truongvanvuembedded/Dishwasher-machine/Bản vẽ/ELECTRONIC-DRAWING.pdf

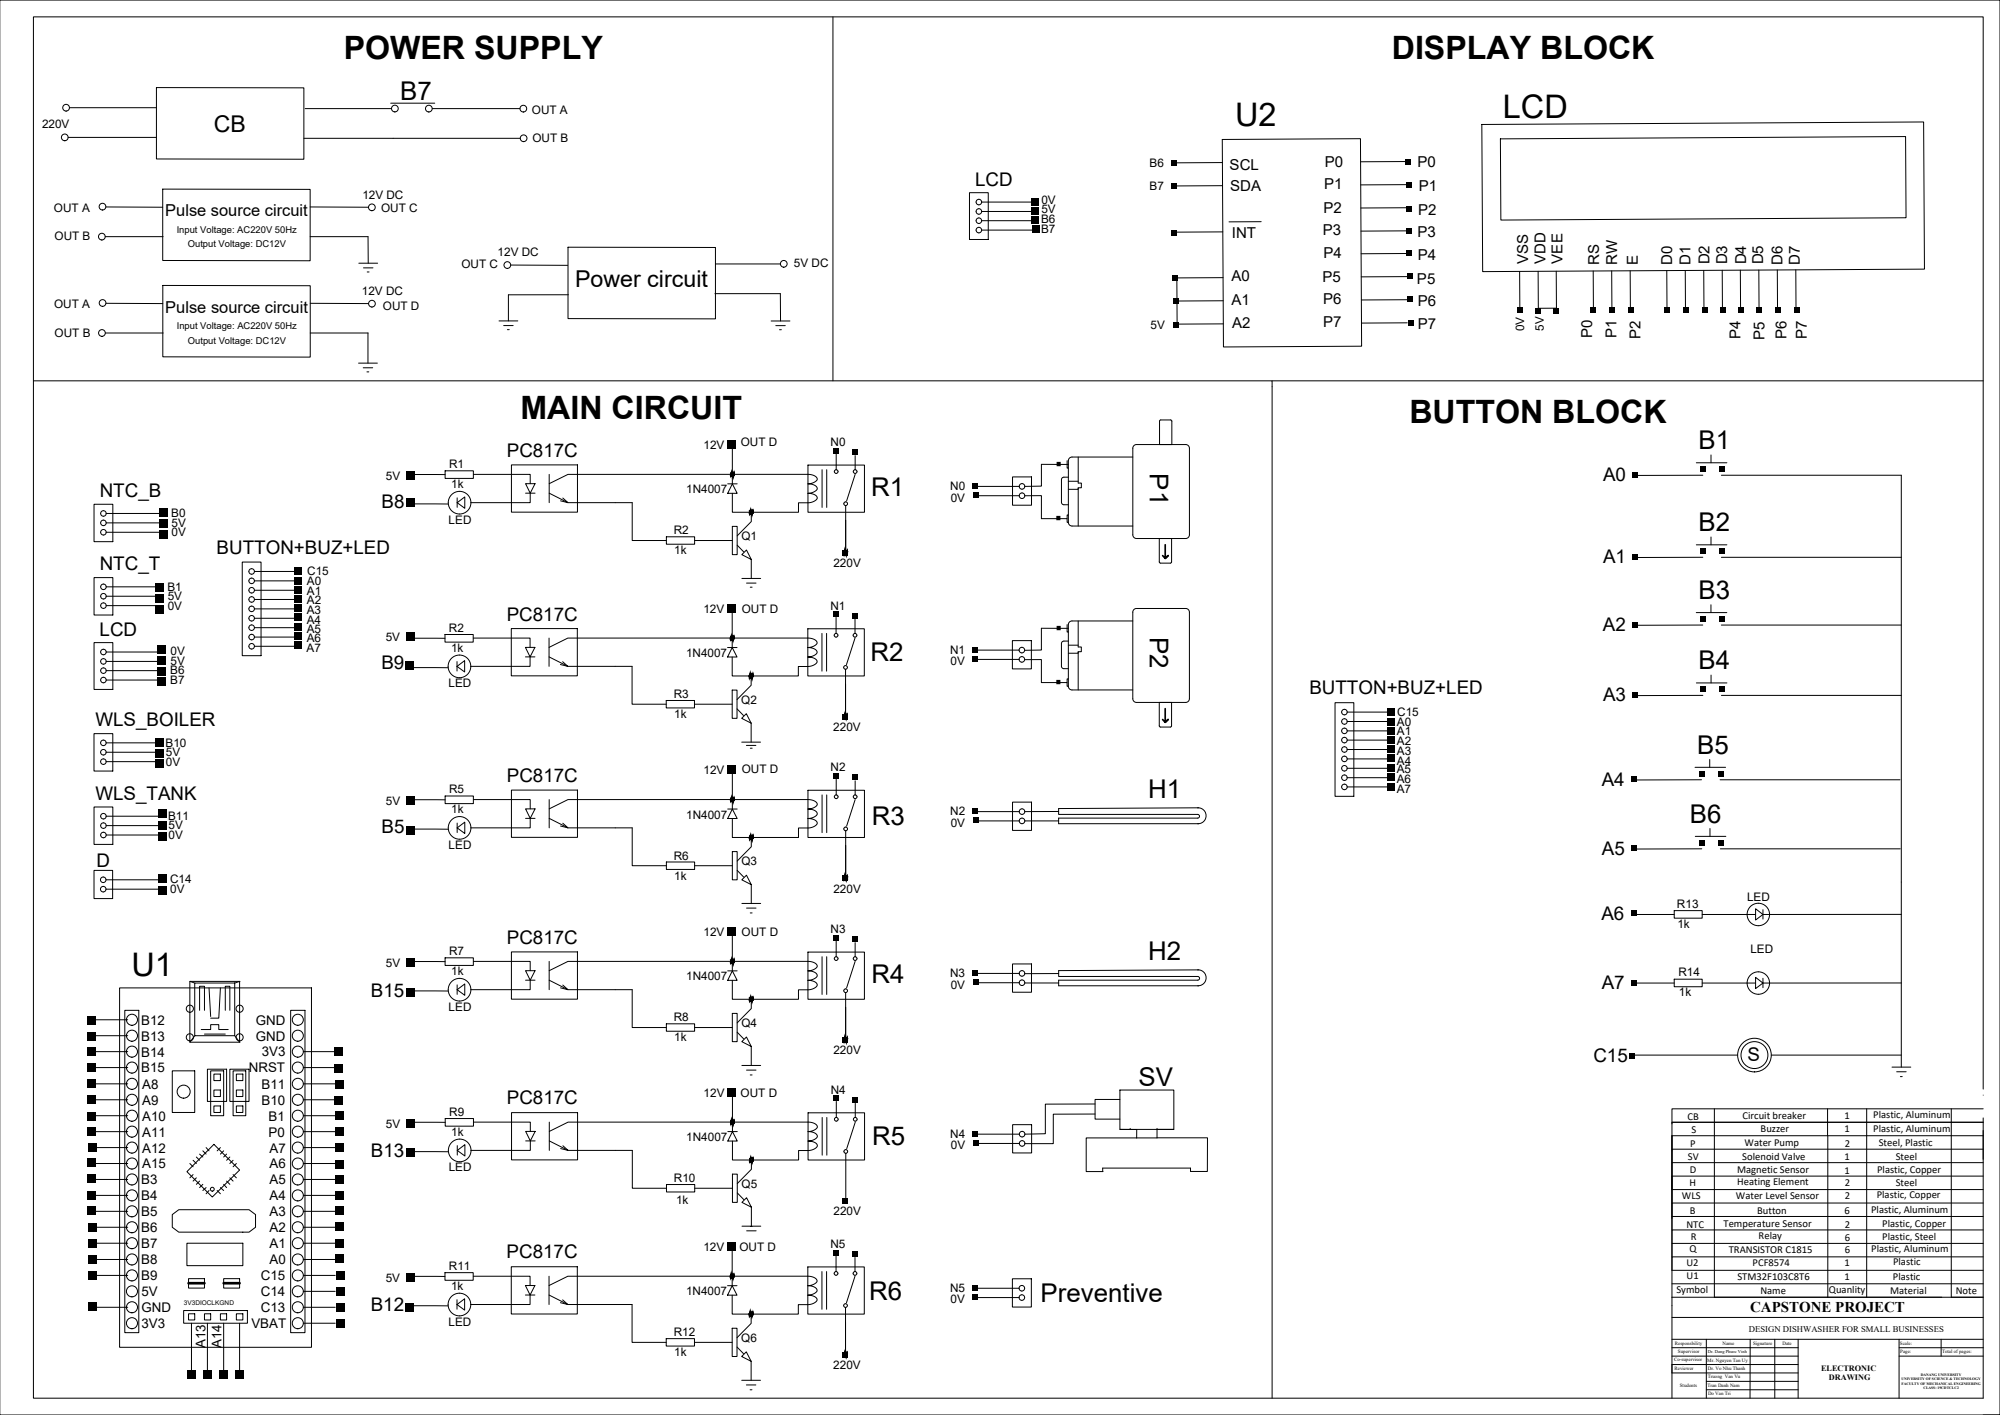
[picture p63: page 1]

5V B6B75V . .................. ................. .................. ......... .... ......... MAIN CIRCUIT DISPLAY BLOCK DESIGN DISHWASHER FOR SMALL BUSINESSES Co-supervisor Mr. Nguyen Tan Uy Tran Danh Nam Do Van Tri Truong Van Vu Plastic Q Plastic, Aluminum R Relay Plastic, Steel B Button 6 Plastic, Aluminum Plastic, Copper Preventive .... .C15 S S Buzzer 1 Plastic, Aluminum OUT A OUT B Pulse source circuit Input Voltage: AC220V 50Hz Output Voltage: DC12V 12V DC OUT A OUT B 12V DC B7 CB Circuit breaker 1 Plastic, Aluminum OUT C OUT C Reviewer Dr. Vo Nhu Thanh BUTTON BLOCK OUT D OUT D OUT D OUT D OUT D OUT D OUT D

P2 H1 H2 SV C15 A0A1A2A3A4A5A6A7 BUTTON+BUZ+LED ..B1 .A0 ..B2 .A1 ..B3 .A2 ..B4 .A3 ..B5 .A4 ..B6 .A5 .A6 .A7 R13 1kR14 1k LED LED 0V5VB6B7 LCD LCD

A14 U10V5VB6B7 LCD B05V0V NTC_B B15V0V NTC_T B10 5V0V WLS_BOILER B11 5V0V WLS_TANKC14 0V D PC817C B8 . 5V R11k LED 1N4007 12V . R21k Q1 N0 220V N0... .. 0V . PC817C B9 . 5V R21k LED 1N4007 12V . R31k Q2 N1 220V N1... .. 0V . PC817C B5 . 5V R51k LED 1N4007 12V . R61k Q3 N2 220V N2... .. 0V . PC817C B15 . 5V R71k LED 1N4007 12V . R81k Q4 N3 220V N3... .. 0V . PC817C B13 . 5V R91k LED 1N4007 12V . R10 1k Q5 N4 220V N4... .. 0V . PC817C B12 . 5V R11 1k LED 1N4007 12V . R12 1k Q6 N5 220V N5... .. 0V . R1 R2 R6R5 R4 R3 C15 A0A1A2A3A4A5A6A7 BUTTON+BUZ+LED . .
