truongvanvuembedded/Dishwasher-machine/Bản vẽ/OPERATION-PRINCIPLE.pdf

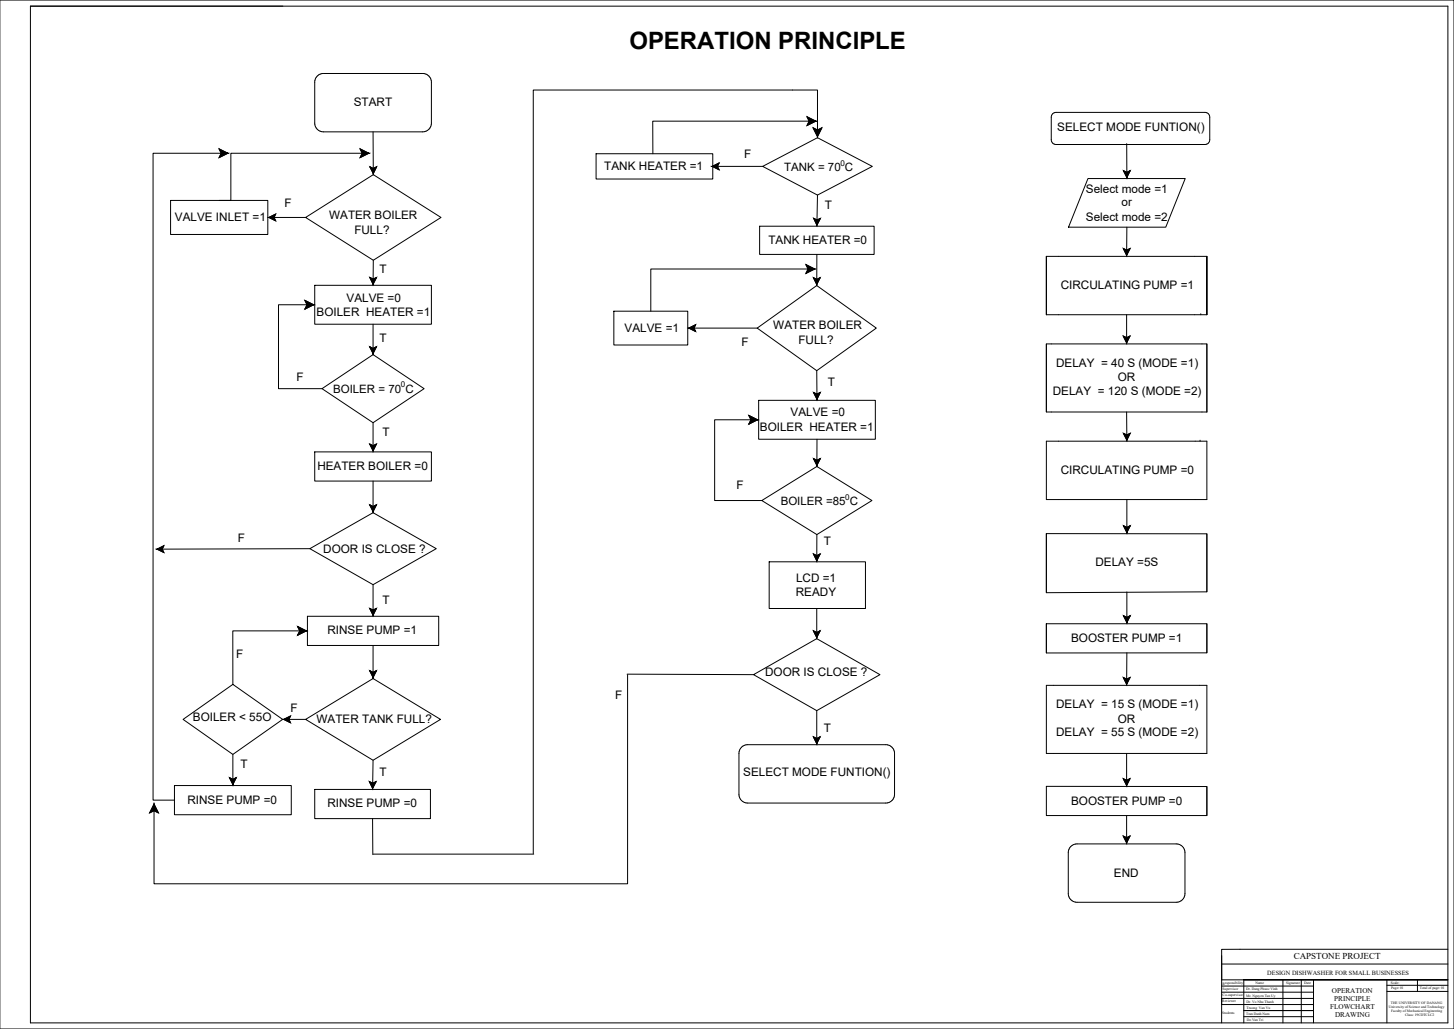
[picture p64: page 1]
WATER BOILER FULL? VALVE =0 BOILER HEATER =1 VALVE INLET =1; T HEATER BOILER =0 WATER TANK FULL? RINSE PUMP =0; TANK HEATER =1; VALVE =0 BOILER HEATER =1 LCD =1 READY DOOR IS CLOSE ? T RINSE PUMP =1 F; TANK HEATER =0 VALVE =1; WATER BOILER F; FULL?T T F BOILER < 55O; T RINSE PUMP =0 T; T DOOR IS CLOSE ? F; T START; SELECT MODE FUNTION()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
