truongvanvuembedded/Dishwasher-machine/Bản vẽ/AS-BUILT DRAWING.pdf

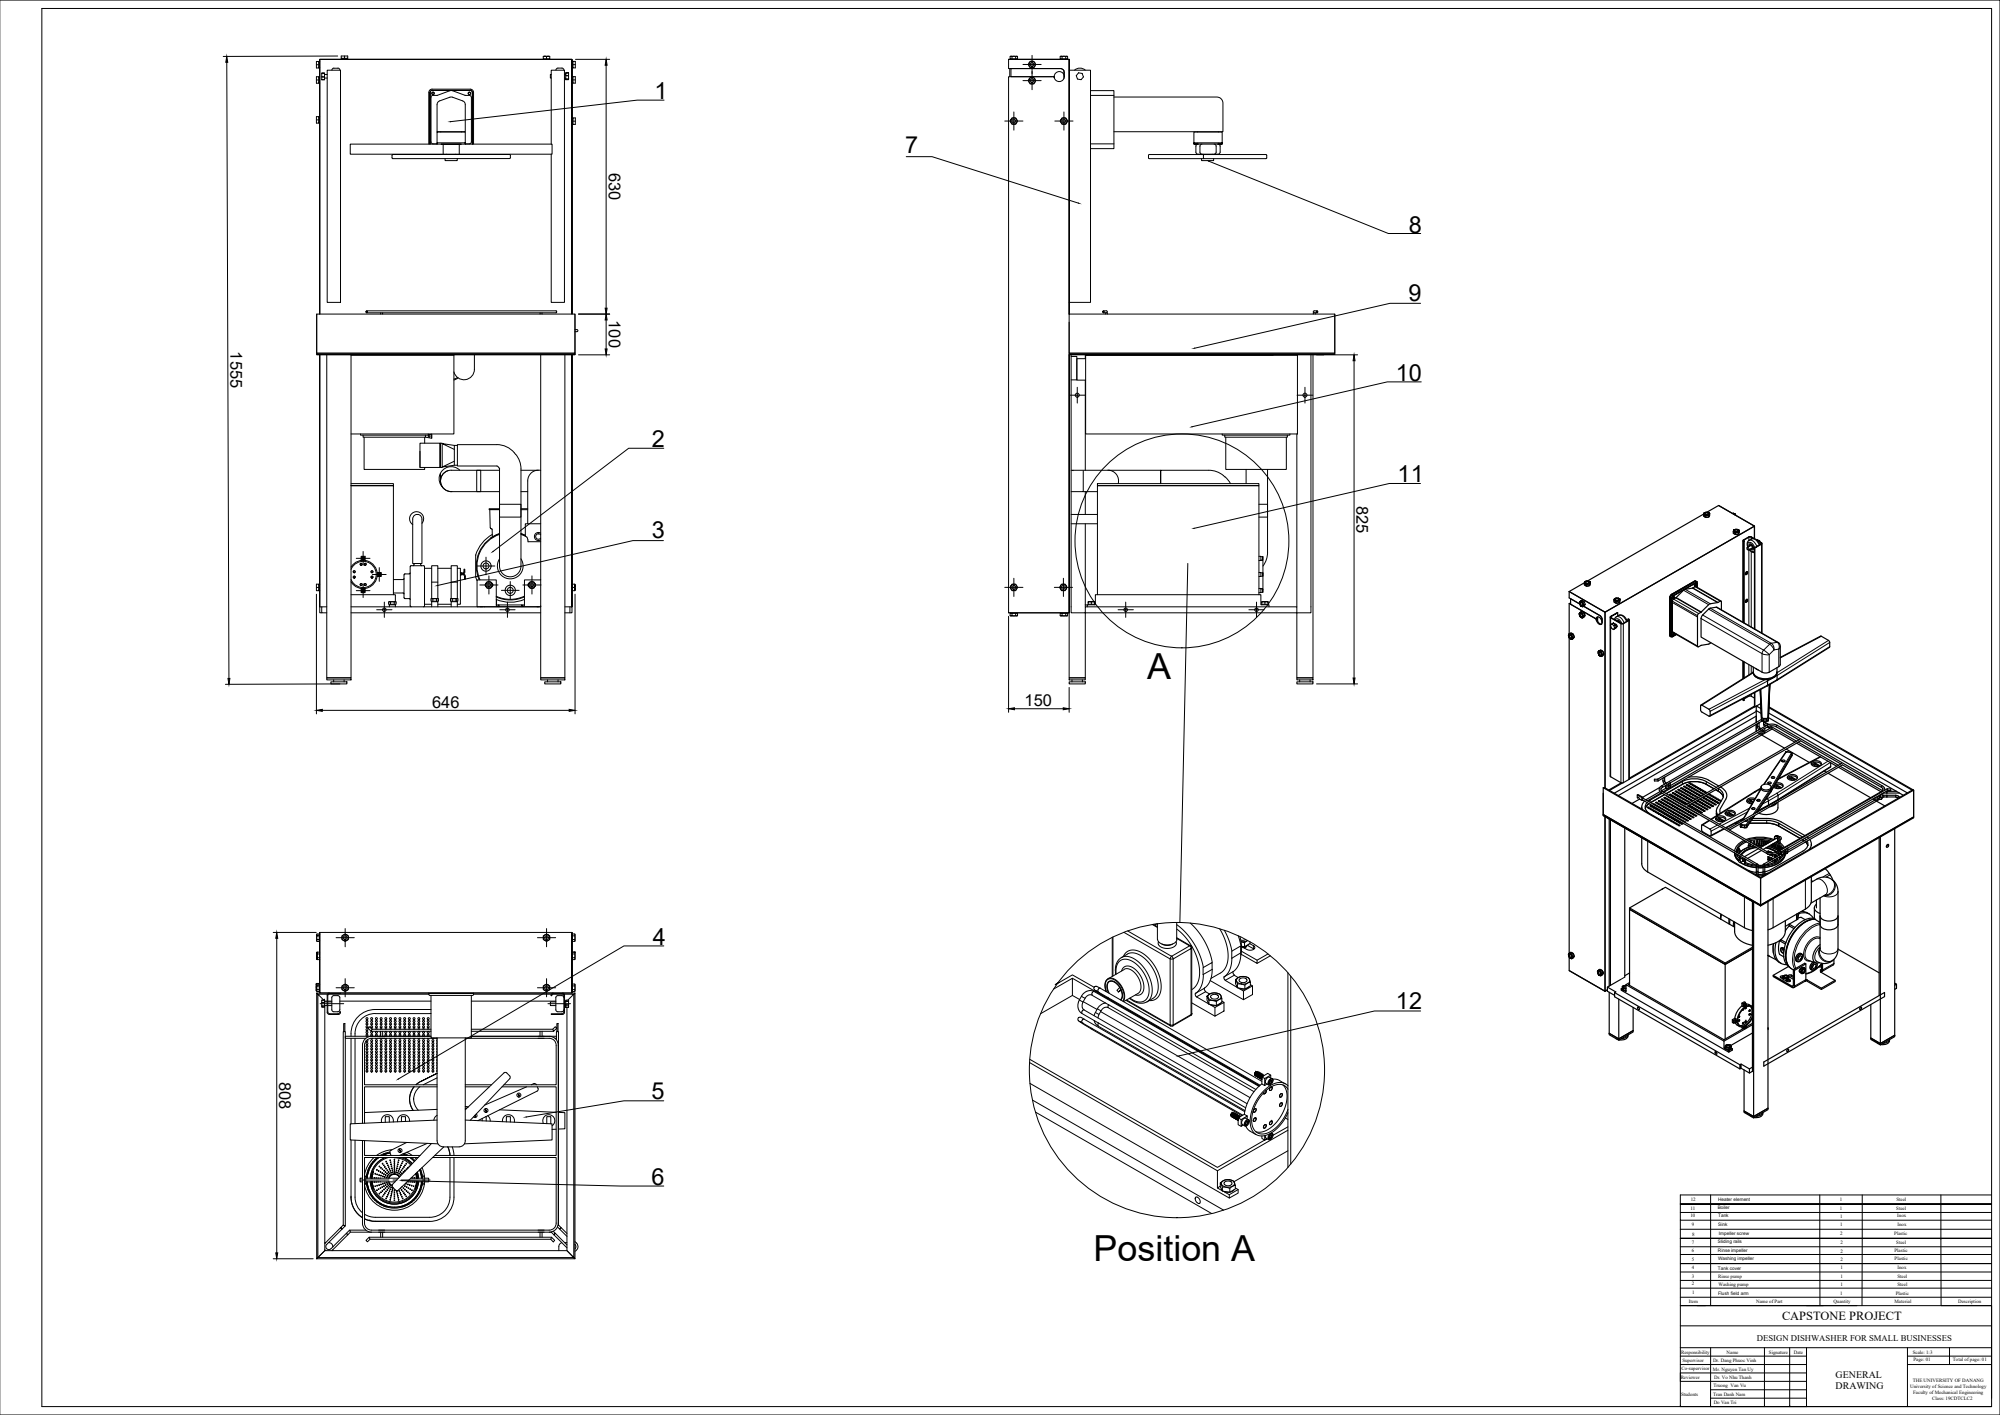
[picture p65: page 1]
CAPSTONE PROJECT DESIGN DISHWASHER FOR SMALL BUSINESSES Responsibility Supervisor Students; Name Tran Danh Nam; Signature; Date; Scale: 1:3 Page: 01; Total of page: 01 GENERAL DRAWING; THE UNIVERSITY OF DANANG University of Science and Technology Faculty of Mechanical Engineering Class: 19CDTCLC2 Dr. Dang Phuoc Vinh Do Van Tri Item; Name of Part; Quantity; Material; Description 1234 Co-supervisor 567; Inox 212112 Mr. Nguyen Tan Uy Washing pump; 2 Truong Van Vu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

1555 646 321654 11109812 Flush field arm 1 Plastic Steel 8 Impeller screw 91011 1111 Sink Inox Boiler Tank Steel Inox 12 Heater element Steel 150

100 630 Reviewer Dr. Vo Nhu Thanh
