truongvanvuembedded/Dishwasher-machine/Bản vẽ/DETAIL-DRAWING.pdf

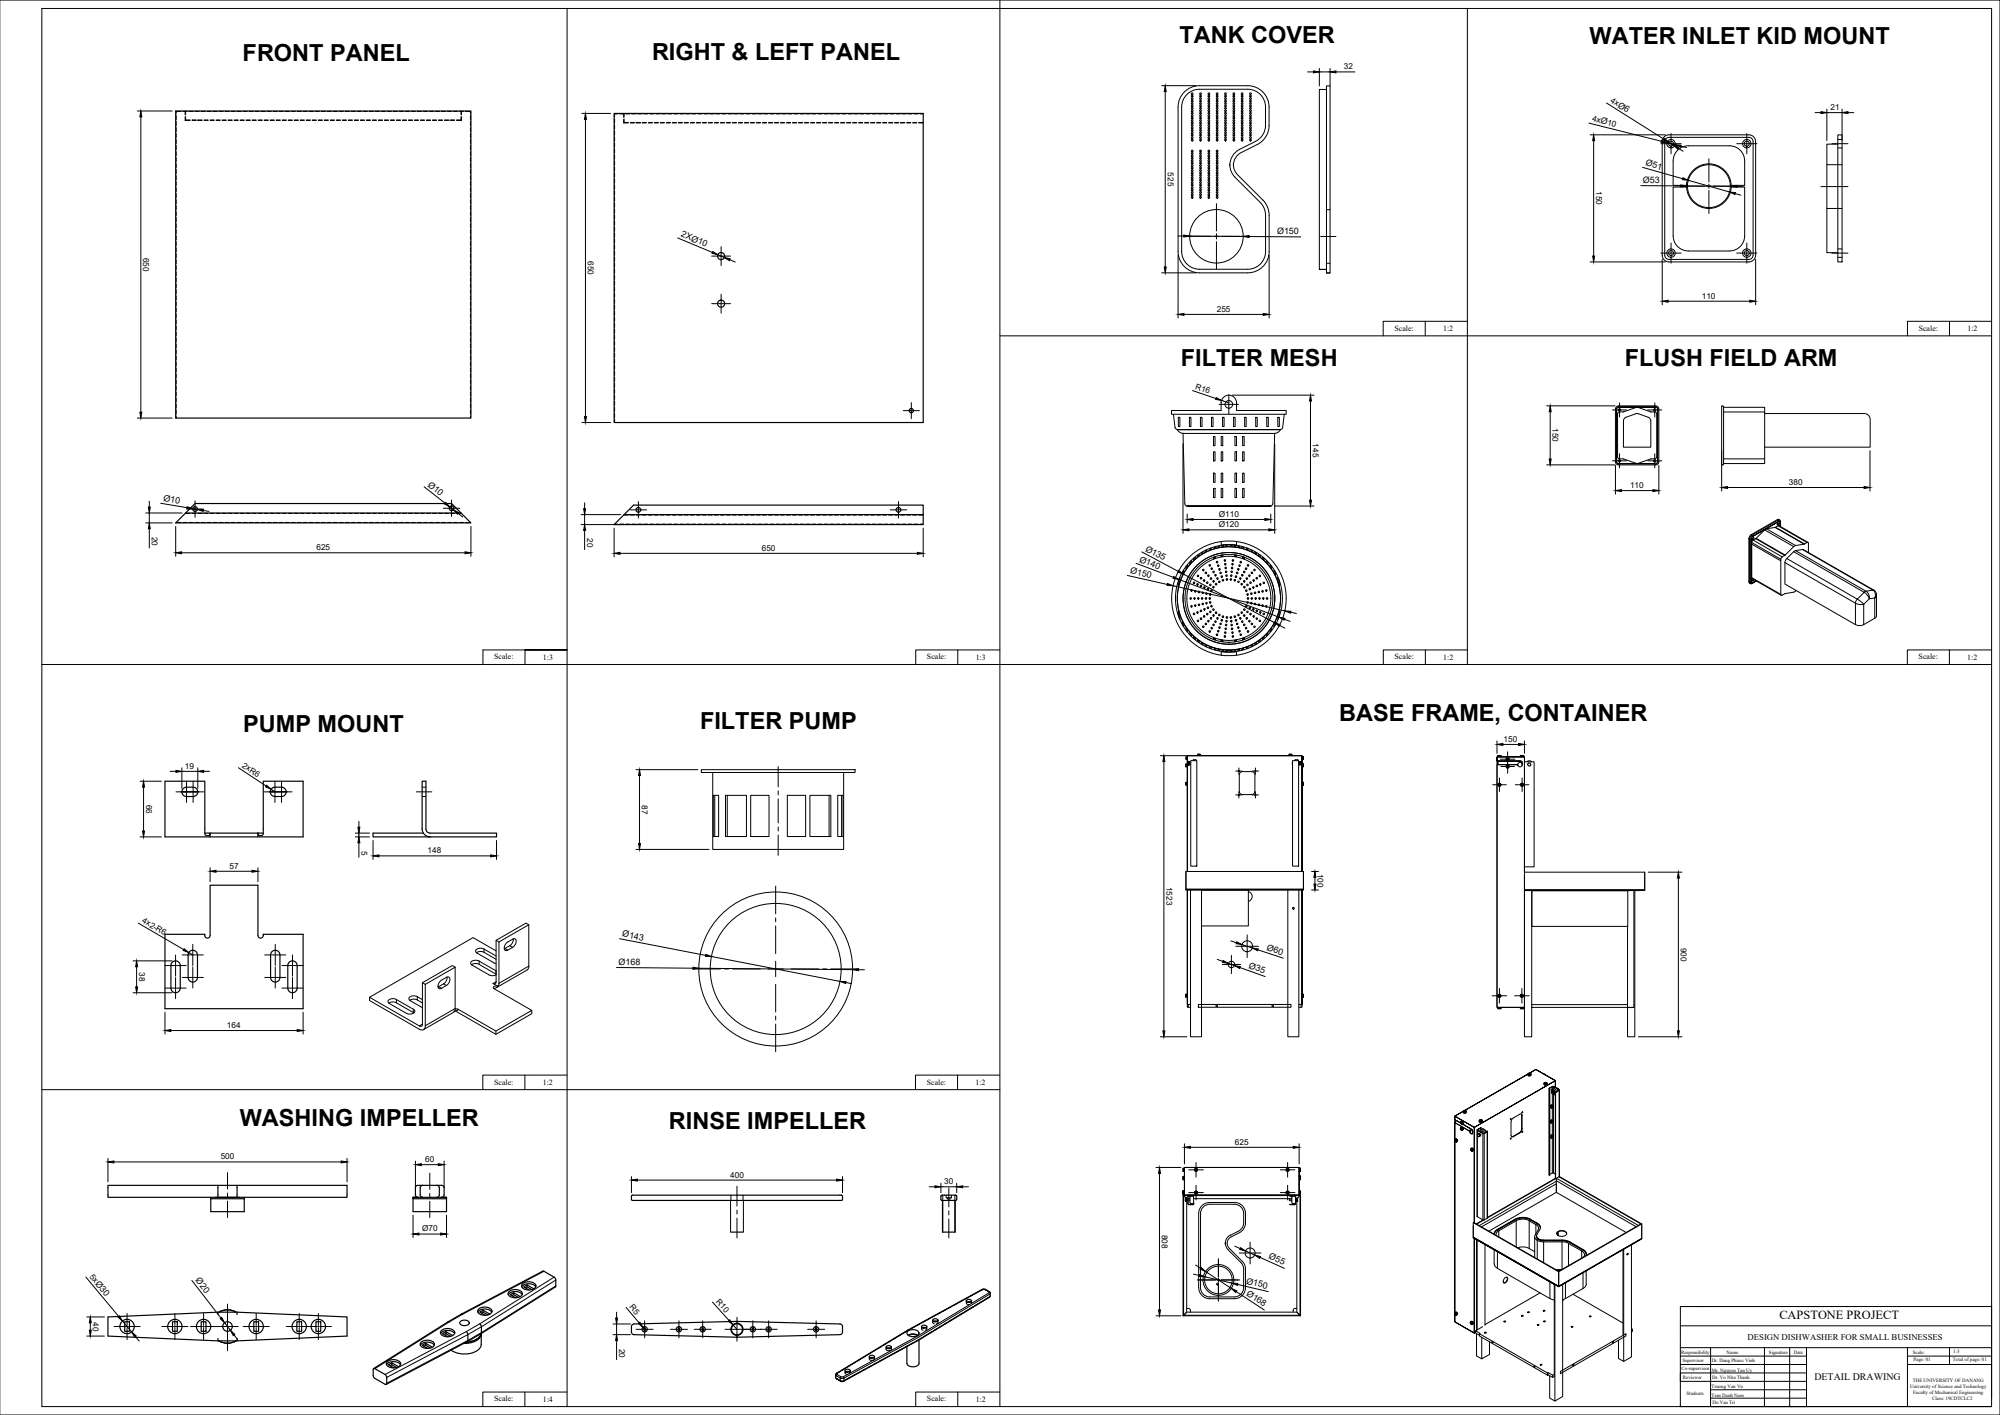
[picture p66: page 1]
CAPSTONE PROJECT Responsibility Supervisor Students; Name; Signature; Date; Scale: Page: 01; Total of page: 01 DETAIL DRAWING; THE UNIVERSITY OF DANANG University of Science and Technology Faculty of Mechanical Engineering Class: 19CDTCLC2 Co-supervisor FRONT PANEL; 38 4x2-R6 148 5 19 PUMP MOUNT 2XØ10 500

20 R5 R10 30 WASHING IMPELLER RINSE IMPELLER BASE FRAME, CONTAINER DESIGN DISHWASHER FOR SMALL BUSINESSES Tran Danh Nam Dr. Dang Phuoc Vinh Truong Van Vu Do Van Tri Mr. Nguyen Tan Uy 2xR6 TANK COVER Ø150

87 WATER INLET KID MOUNT FLUSH FIELD ARM

20 RIGHT & LEFT PANEL 57

525 255 32 Ø20 5xØ30 FILTER MESH Ø150 Ø140 Ø135 Ø110 Ø120 R16 FILTER PUMP Ø168 Ø143

900 Reviewer Dr. Vo Nhu Thanh Ø168 Ø150Ø55 Ø60 Ø35 1:3 Scale: 1:3 Scale: 1:3 Scale: 1:2 Scale: 1:2 Scale: 1:2 Scale: 1:2 Scale: 1:2 Scale: 1:2 Scale: 1:4 Scale: 1:2
