truongvanvuembedded/Dishwasher-machine/Bản vẽ/EXPLODED-VIEW DRAWING.pdf

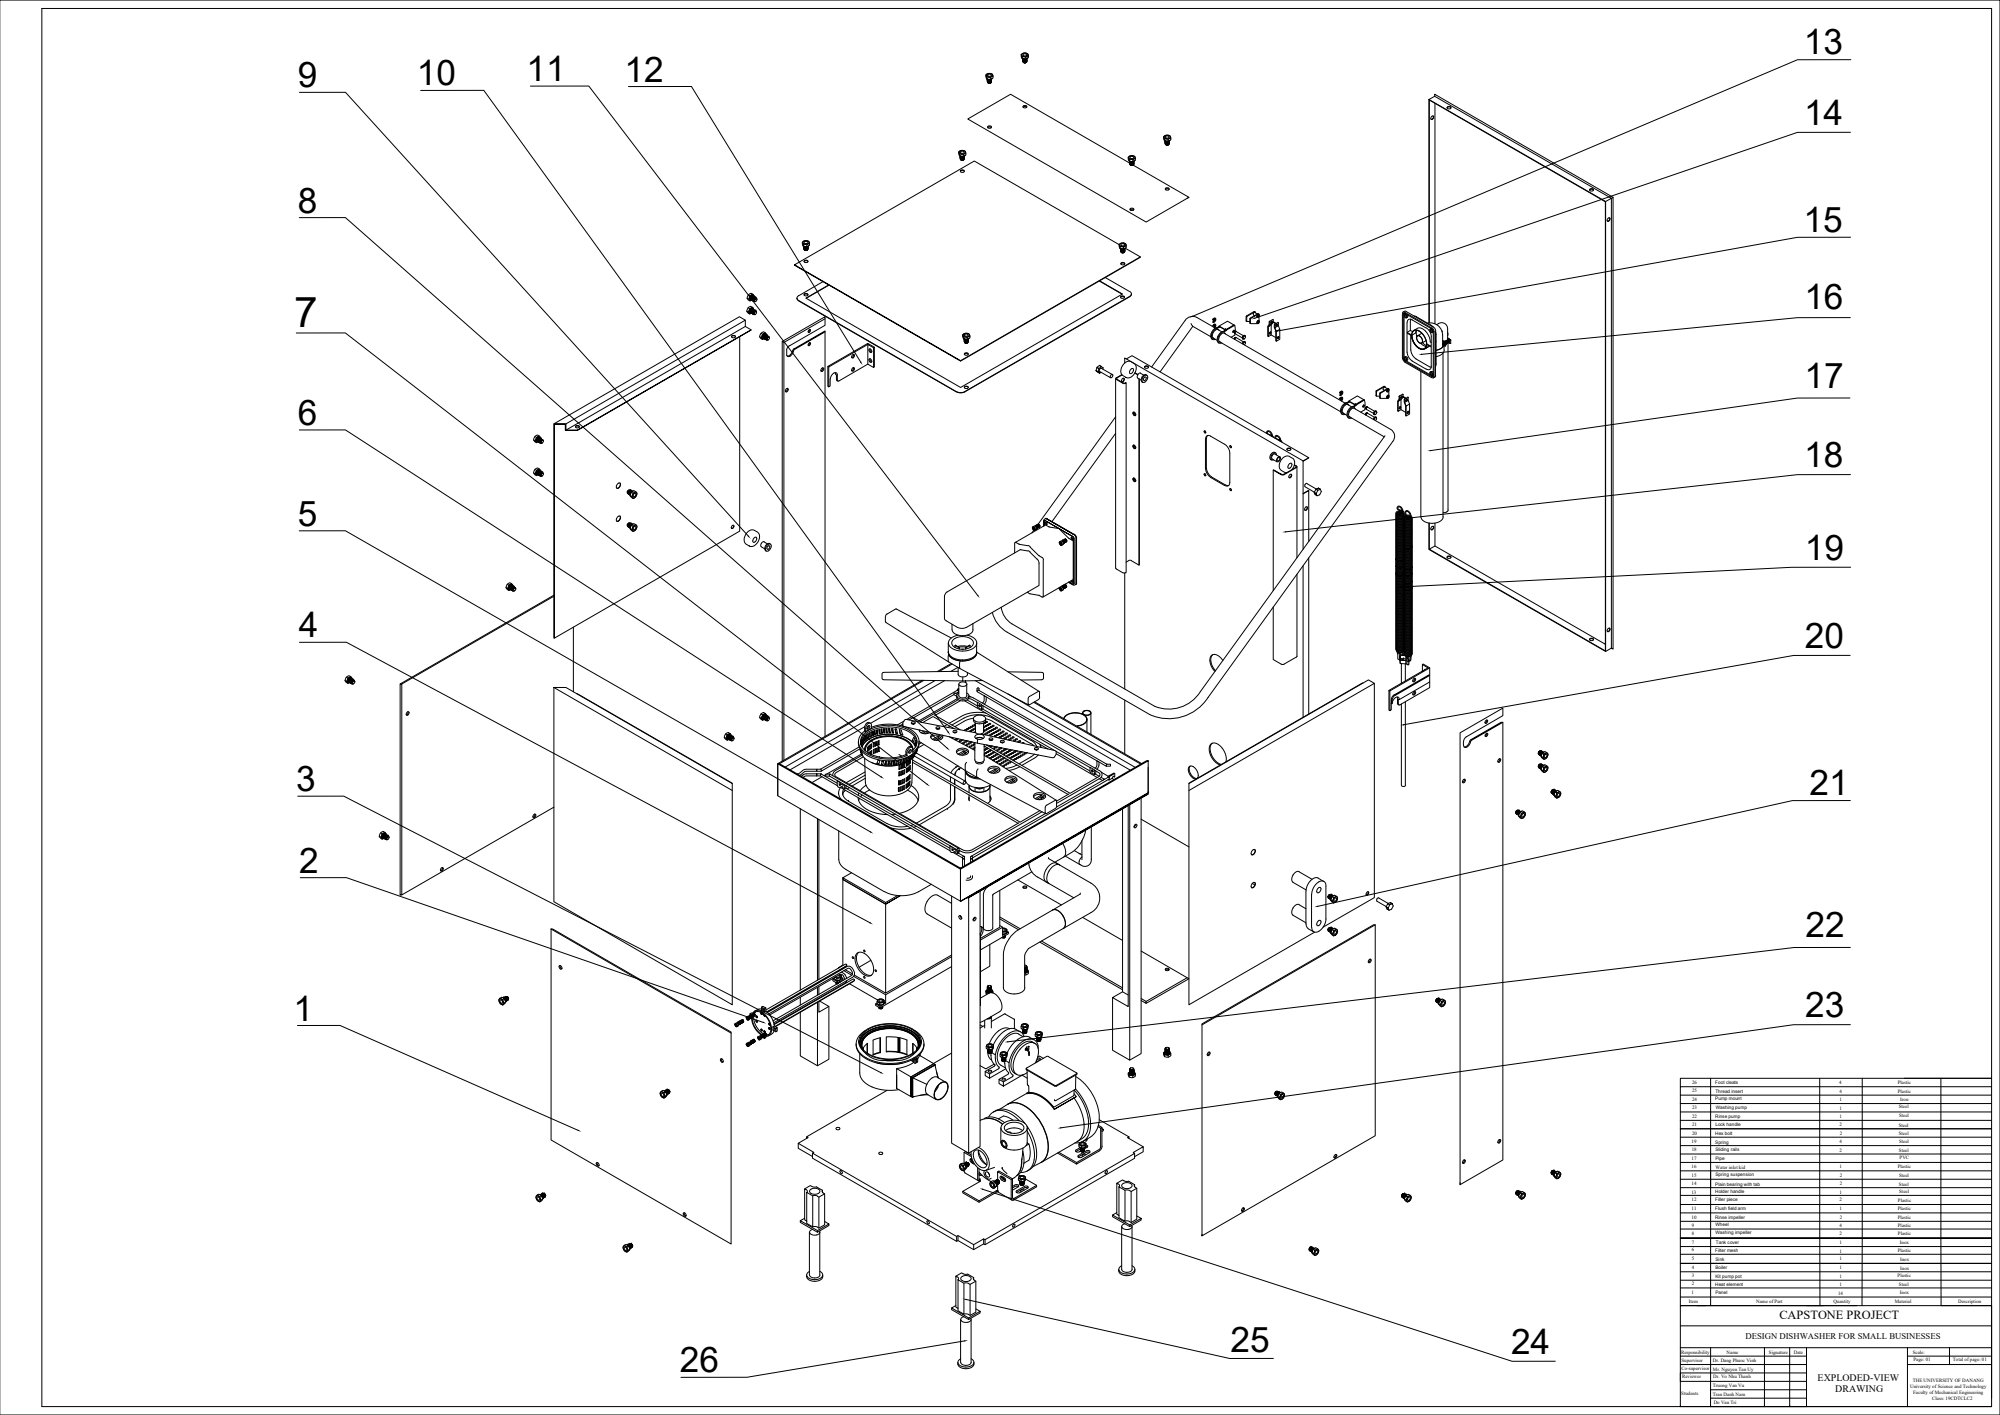
[picture p67: page 1]
CAPSTONE PROJECT Responsibility Supervisor Students; Name Tran Danh Nam; Signature; Date; Scale: Page: 01; Total of page: 01 EXPLODED-VIEW DRAWING; THE UNIVERSITY OF DANANG University of Science and Technology Faculty of Mechanical Engineering Class: 19CDTCLC2 Dr. Dang Phuoc Vinh Truong Van Vu Do Van Tri Co-supervisor; Mr. Nguyen Tan Uy Item; Name of Part; Quantity; Material; Description; Washing impeller; Plastic Rinse impeller; Spring suspension; Steel 16; Water inlet kid 17; Pipe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

Hex bolt | 4 1 2 Flush field arm 4 Sliding rails 2 | Plastic 2 Holder handle Plastic Plastic Wheel Plastic Tank cover Filter mesh Heat element Steel Spring Steel Steel 2 Steel DESIGN DISHWASHER FOR SMALL BUSINESSES Steel Filler piece PVC 181920

Plain bearing with tab | 2 11121314 | Steel Plastic Inox Plastic Inox Kit pump pot

6 | 1 Panel Sink 8 1

7 5 | 14 1 | Inox

3 | 1 1 Boiler
