truongvanvuembedded/Dishwasher-machine/Bản vẽ/FLOWCHART-DRAWING.pdf

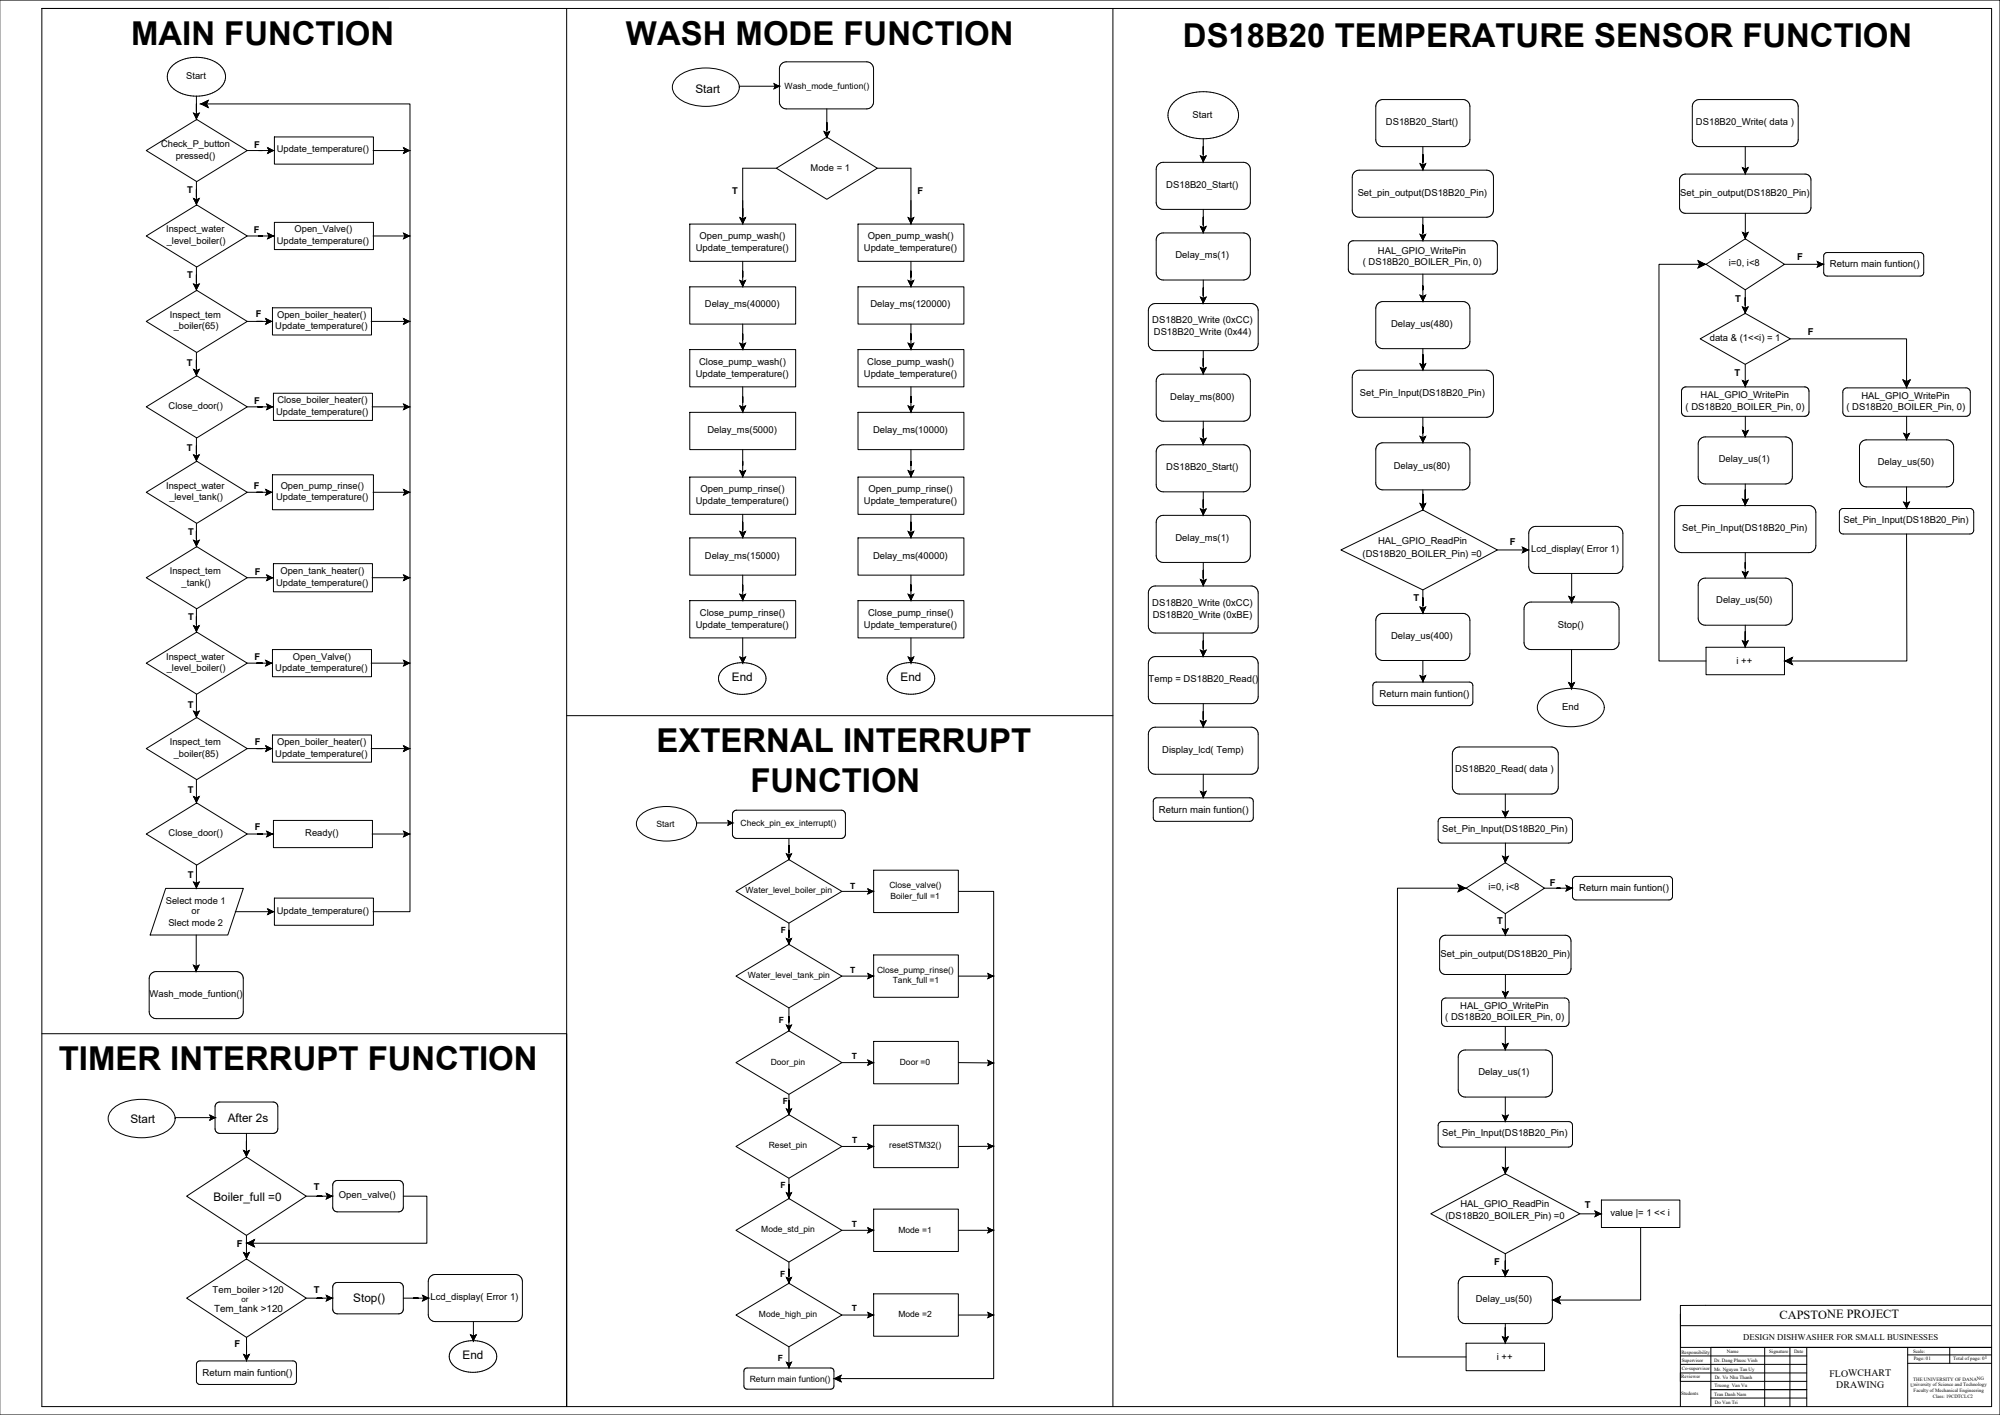
[picture p68: page 1]
WASH MODE FUNCTION Open_pump_wash() Update_temperature() Delay_ms(40000) Close_pump_wash() Update_temperature() Delay_ms(5000) Open_pump_rinse() Update_temperature() Delay_ms(15000) Close_pump_rinse() Update_temperature(); Open_pump_wash() Update_temperature() Delay_ms(120000) Close_pump_wash() Update_temperature() Delay_ms(10000) Open_pump_rinse() Update_temperature() Delay_ms(40000) Close_pump_rinse() Update_temperature() MAIN FUNCTION Check_P_button pressed()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
