truongvanvuembedded/Dishwasher-machine/(notices)

Notices in the files:
code_using_keil_c/Core/Inc/main.h:
Copyright (c) 2023 STMicroelectronics.
All rights reserved.
This software is licensed under terms that can be found in the LICENSE file
